cscott/maker-day-kit/SolderingTurkey/schematic.pdf

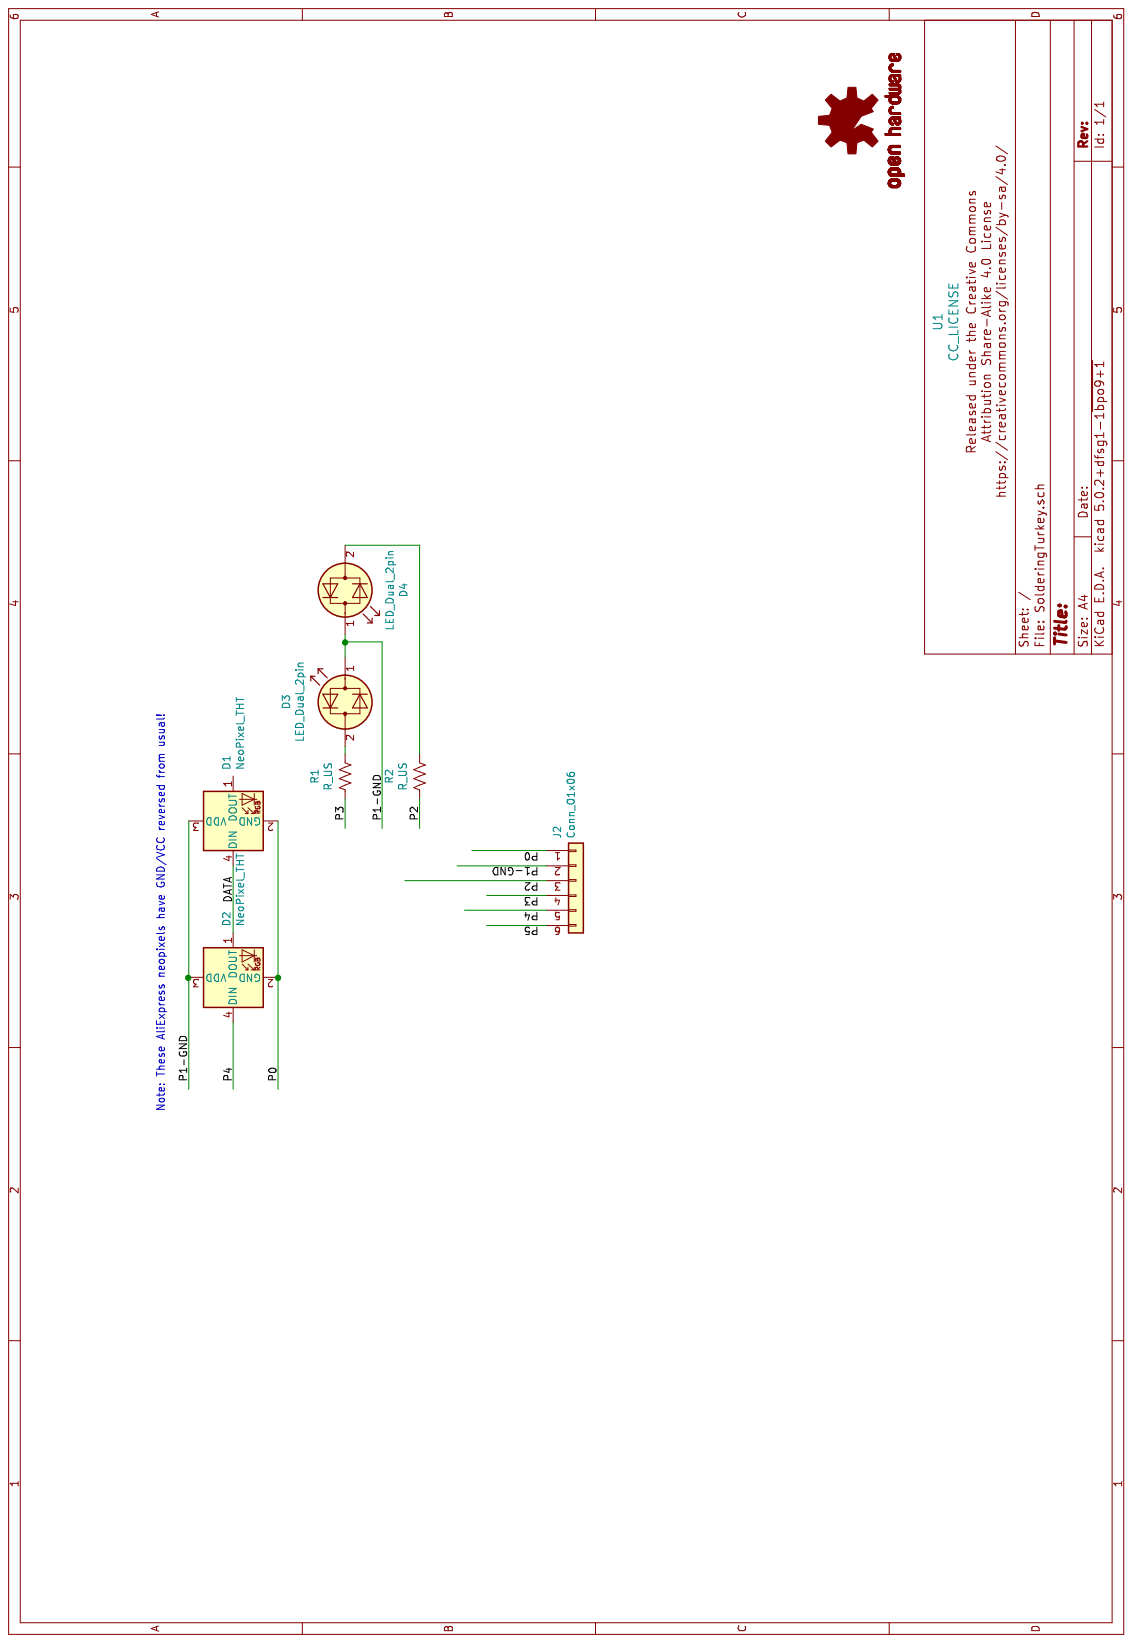
[picture p9: page 1]
