cscott/maker-day-kit/StaringTurkey/schematic.pdf

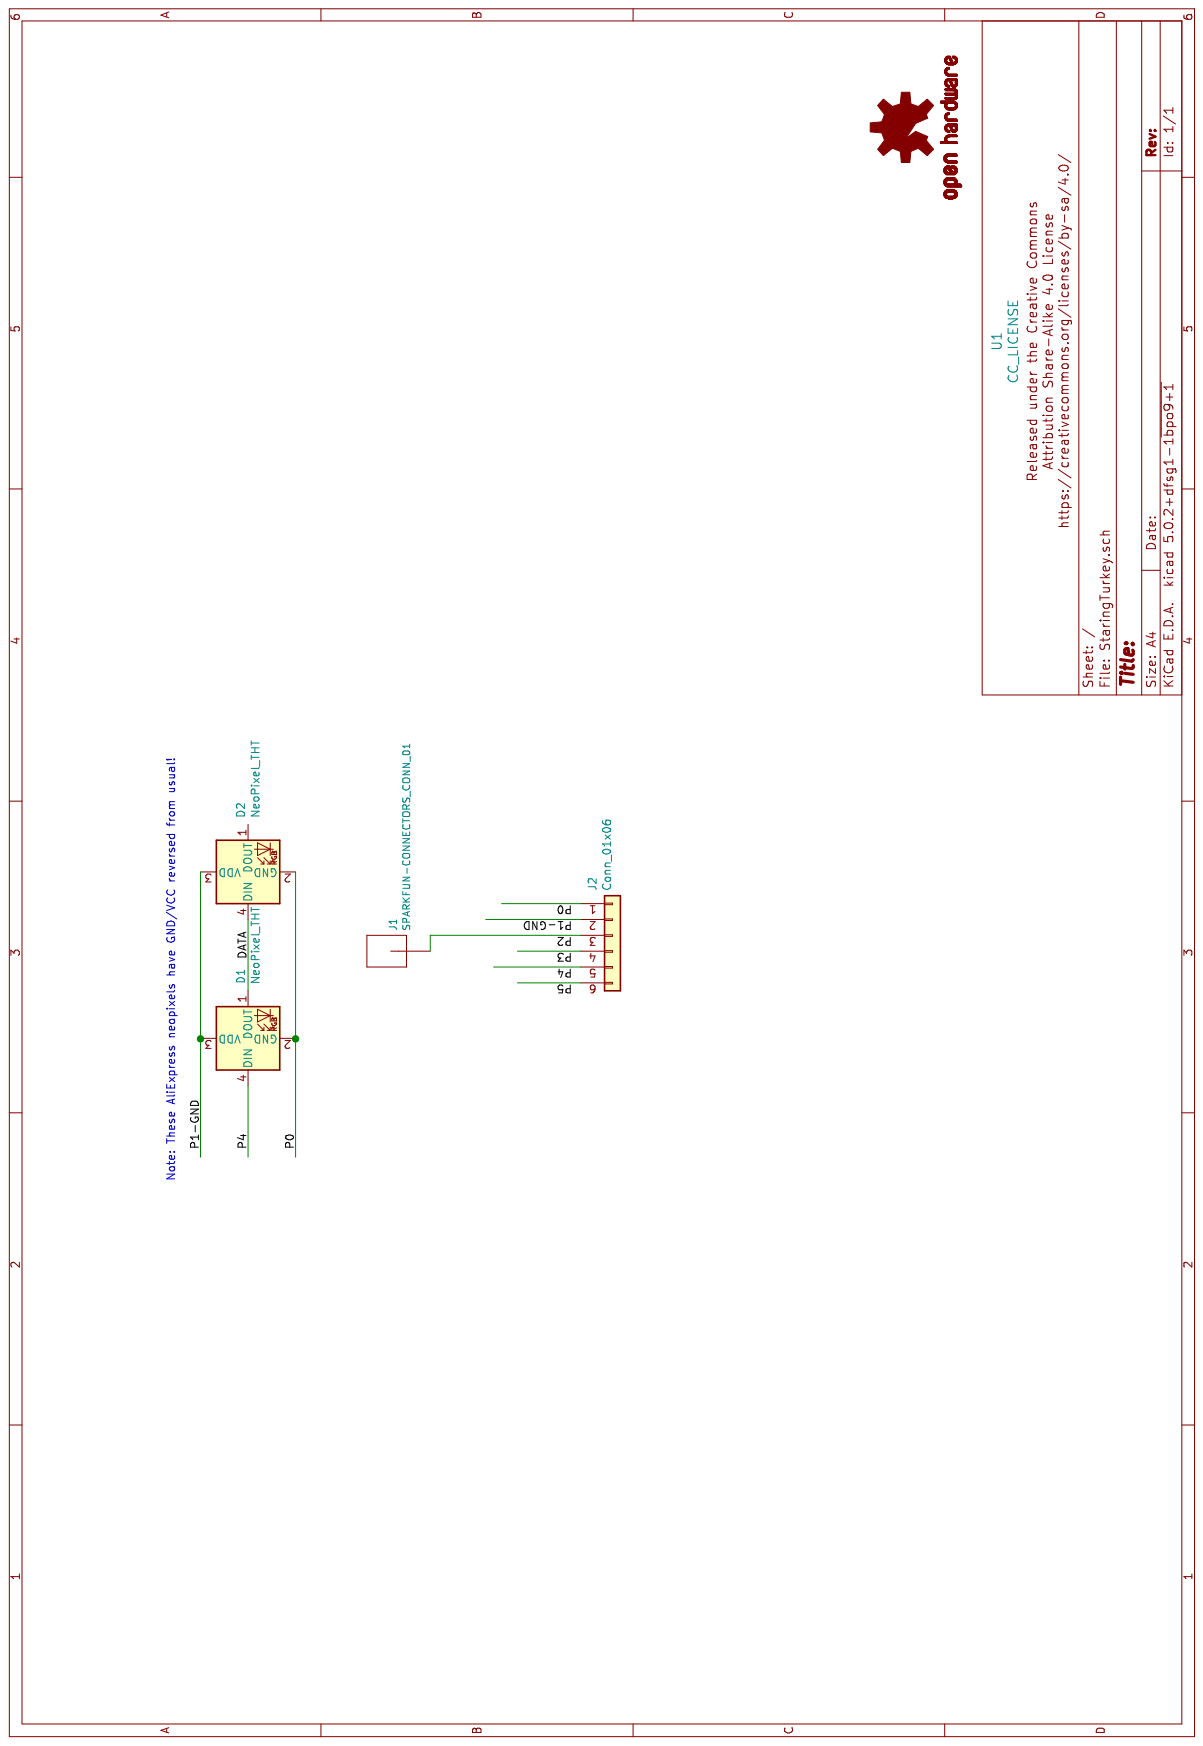
[picture p10: page 1]
