cscott/maker-day-kit/(commit log)

2019-04-05 Initial schematic and reduced-color PCB for "staring turkey"
    [StaringTurkey.kicad_pcb, StaringTurkey.sch]
2019-04-05 Make PCB layers using svg2shenzhen
    Needed to hack svg2shenzhen by changing line 503 of export.py from
    root.remove(layer)
    to
    layer.attrib['style'] = 'display:none'
2019-04-05 First attempt: with solder jumpers to turn the LEDs around
    I don't think this will actually work on what's effectively a single-sided
    board.
    [StaringTurkey.kicad_pcb, StaringTurkey.sch]
2019-04-05 Tweak the silkscreen
    [StaringTurkey.kicad_pcb]
2019-04-06 v1, for real -- swap PWR and GND on the NeoPixels.
    Sanity checking against my just-arrived 5mm NeoPixels from aliexpress
    revealed that power and ground were reversed on these bad boys. Fun.
    [StaringTurkey.kicad_pcb, StaringTurkey.sch]
2019-04-06 Begin the soldering turkey by copying schematic from staring turkey.
    [SolderingTurkey.kicad_pcb, SolderingTurkey.sch]
2019-04-06 v1 of the soldering turkey
    [SolderingTurkey.kicad_pcb, SolderingTurkey.sch]
2019-04-07 v2 of both boards
    Fix net for plated-through hanging hole for Staring Turkey.
    Fix small LED polarity for Soldering Turkey.
    [SolderingTurkey.kicad_pcb, SolderingTurkey.sch, StaringTurkey.kicad_pcb]
2019-04-08 Last minute tweaks -- these are the Gerbers sent to fabrication
    [SolderingTurkey.kicad_pcb, StaringTurkey.kicad_pcb]
2019-04-08 Version 3 of the boards: now with a URL on the board!
    [SolderingTurkey.kicad_pcb, StaringTurkey.kicad_pcb]
2019-05-11 Add a better blinky program for the soldering turkey.
